mwhagedorn/AGC_DSKY_Replica/Photos/LED Layout.pdf

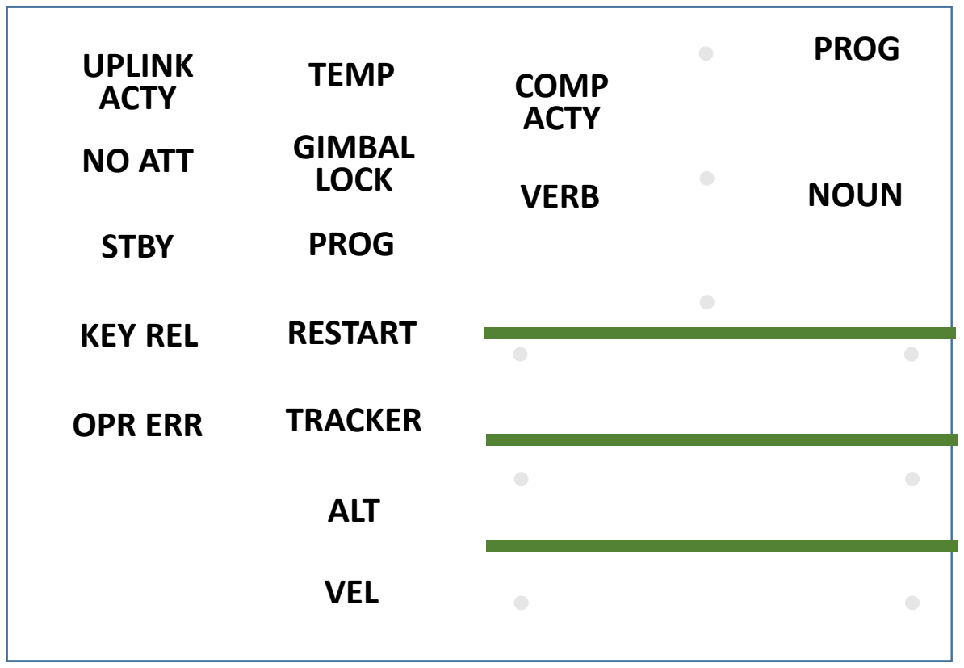
[picture p42: figure]
UPLINK ACTY; GIMBAL LOCK NO ATT; STBY; KEY REL; OPR ERR; TEMP; PROG; RESTART; TRACKER; ALT; VEL; COMP ACTY; VERB; NOUN
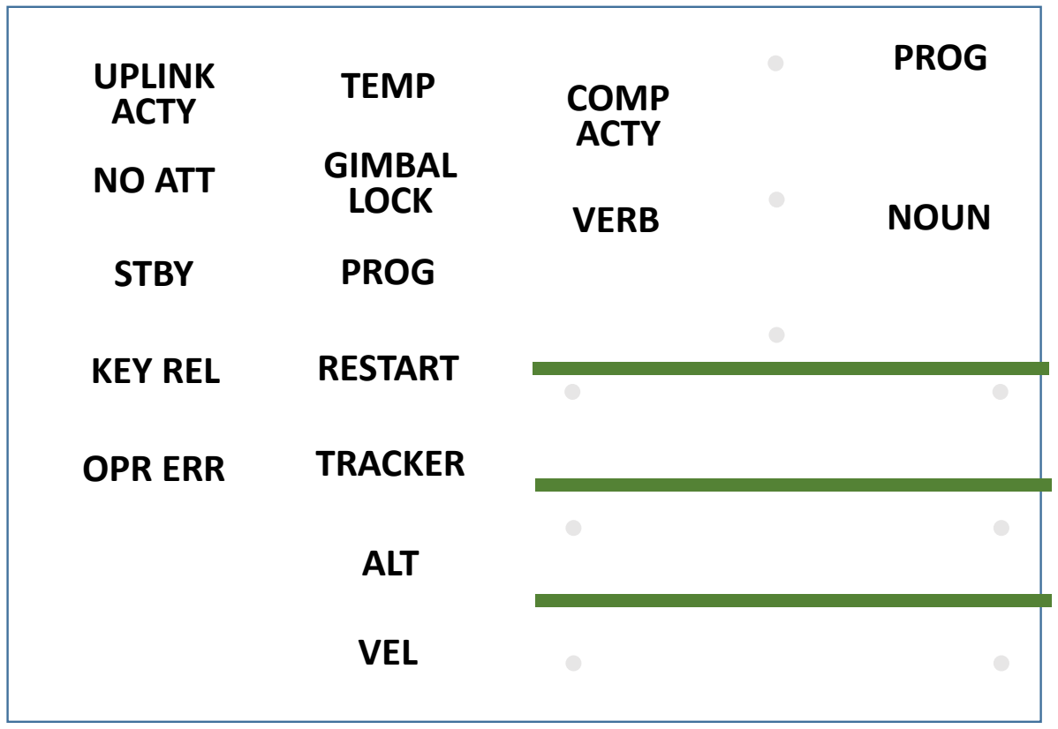
[picture p43: figure]
UPLINK ACTY; GIMBAL LOCK NO ATT; STBY; KEY REL; OPR ERR; TEMP; PROG; RESTART; TRACKER; ALT; VEL; COMP ACTY; VERB; NOUN
