mwhagedorn/AGC_DSKY_Replica/_ref/2226631608115538970.jpeg

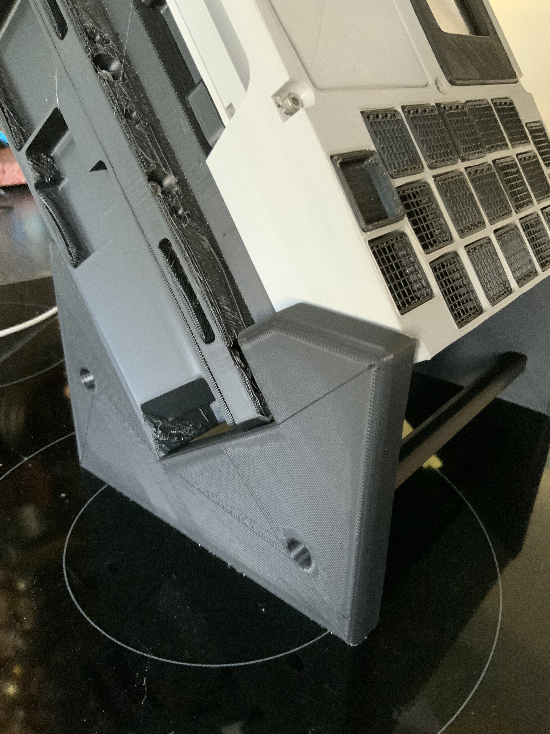
_ref/2226631608115538970.jpeg
