mwhagedorn/AGC_DSKY_Replica/_ref/2257991608116226826.jpeg

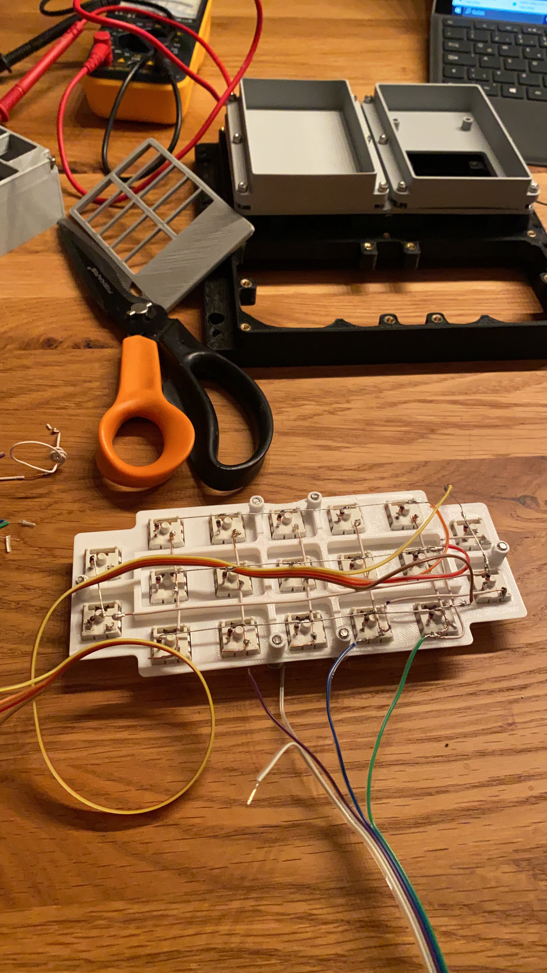
_ref/2257991608116226826.jpeg
