mwhagedorn/AGC_DSKY_Replica/_ref/original license.JPG

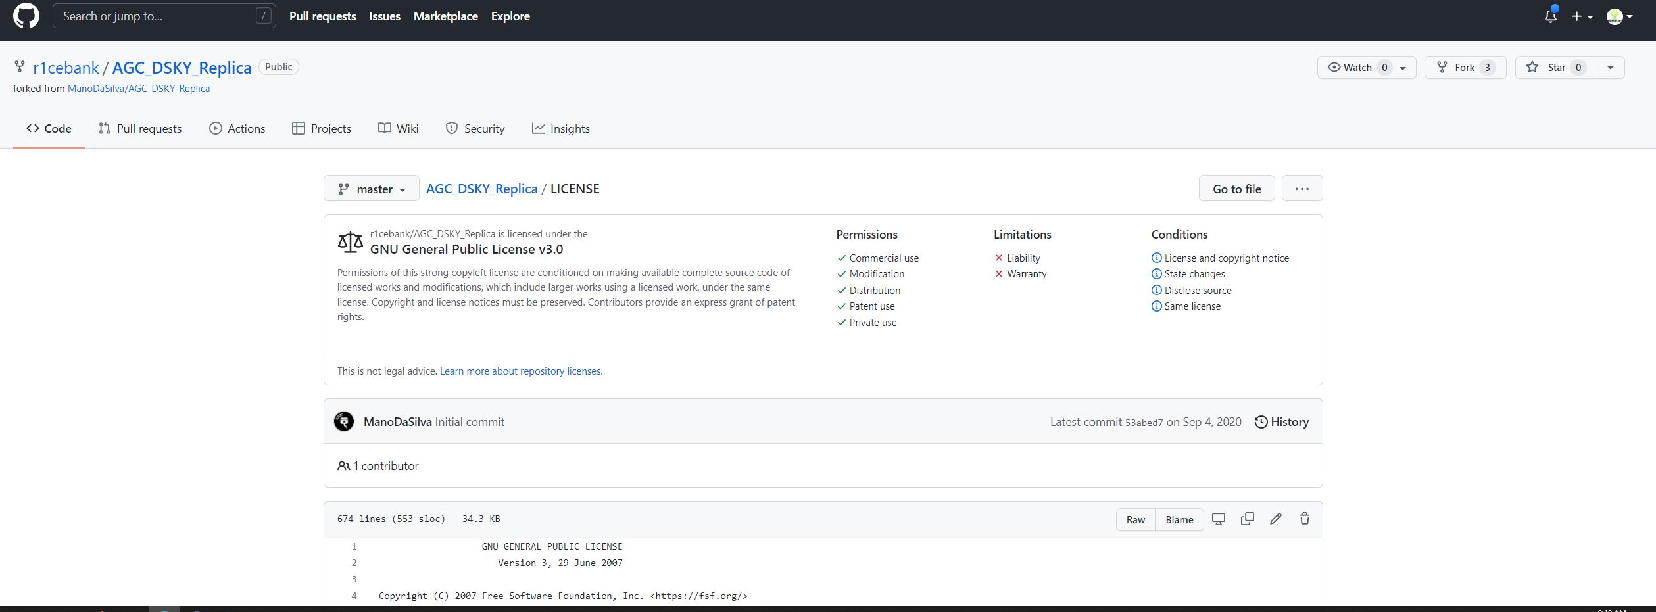
_ref/original license.JPG
