mwhagedorn/AGC_DSKY_Replica/Capture.JPG

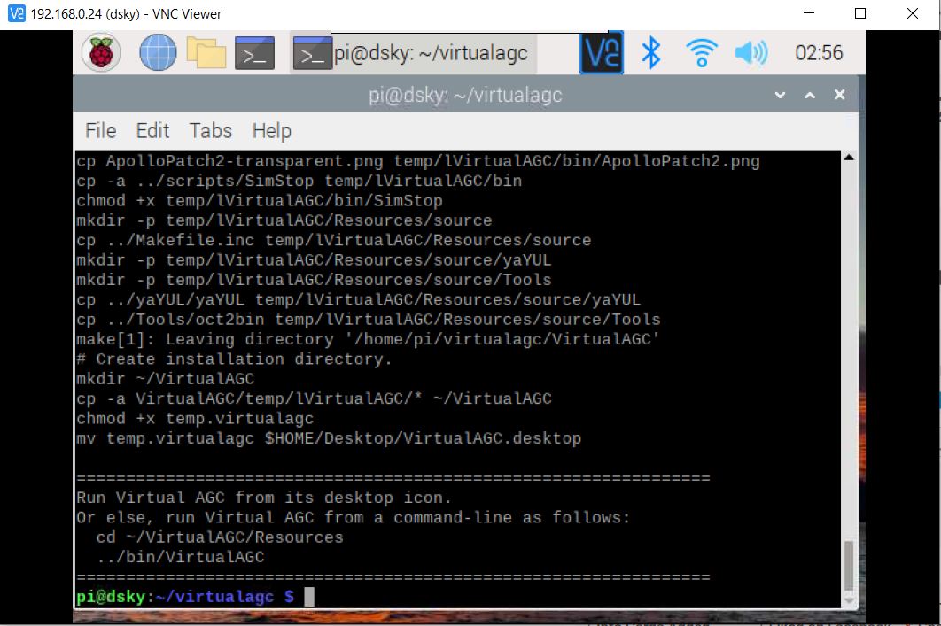
Capture.JPG
