mwhagedorn/AGC_DSKY_Replica/elixir_keyboard/dsky_keyboard_input/s-l400.jpg

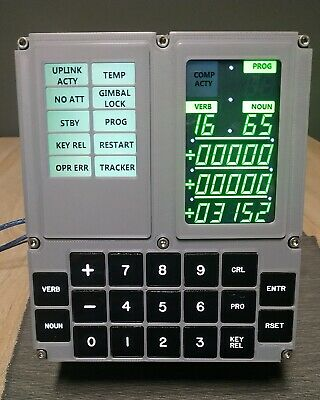
elixir_keyboard/dsky_keyboard_input/s-l400.jpg
