mwhagedorn/AGC_DSKY_Replica/Photos/2ADB911E-929F-4365-B093-D4F5ADEA4741.jpg

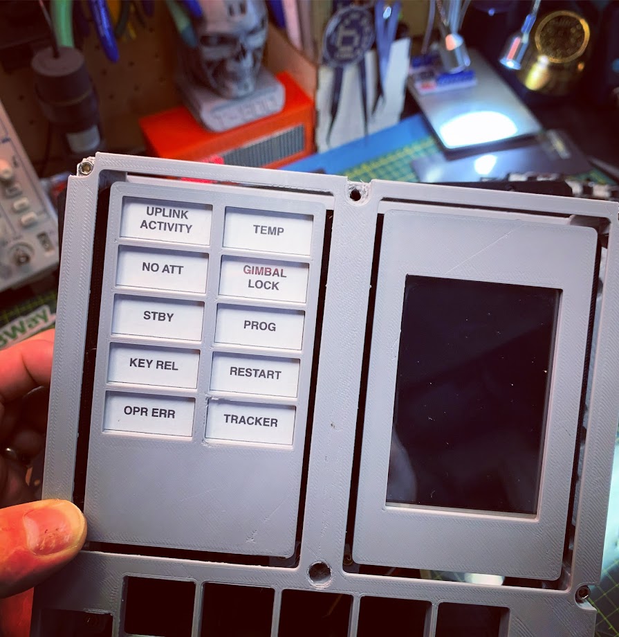
Photos/2ADB911E-929F-4365-B093-D4F5ADEA4741.jpg
