mwhagedorn/AGC_DSKY_Replica/Photos/7D12B138-8DF7-4C67-B199-76621CF2F9C1.jpg

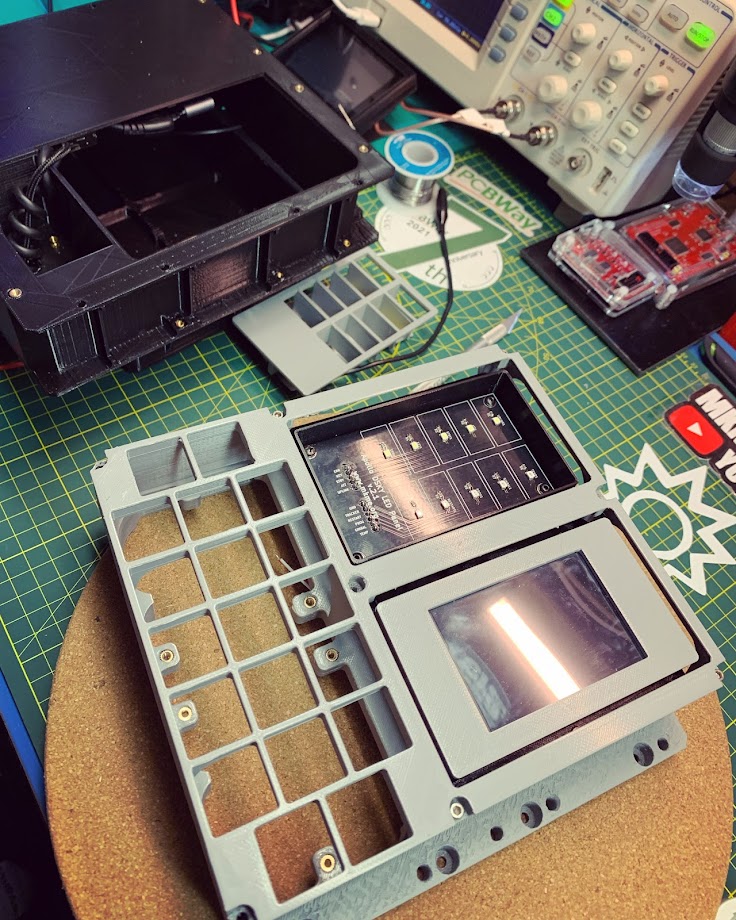
Photos/7D12B138-8DF7-4C67-B199-76621CF2F9C1.jpg
