mwhagedorn/AGC_DSKY_Replica/Photos/034ACF88-DA98-4DAB-A43B-C7C7AC291227.jpg

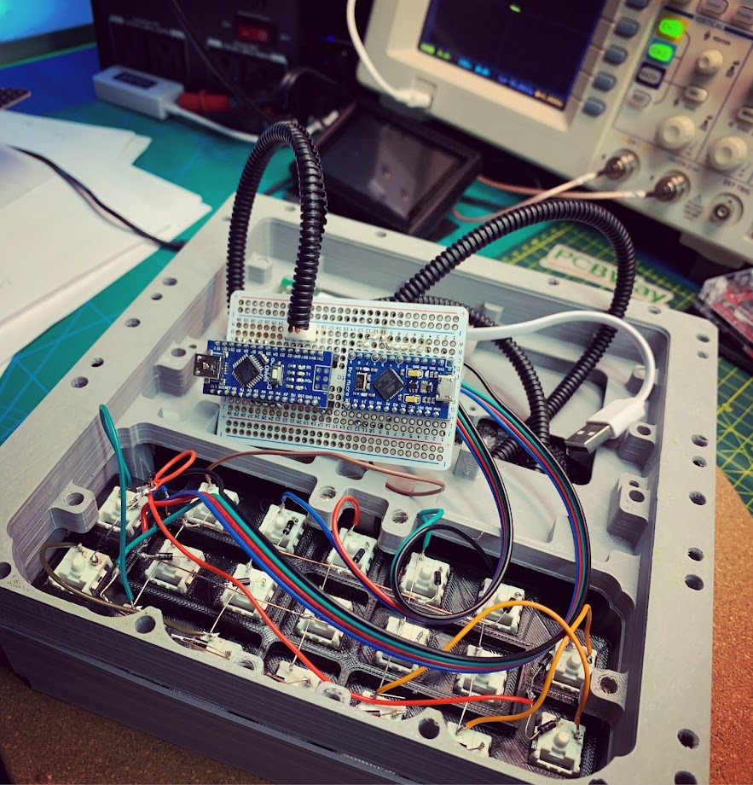
Photos/034ACF88-DA98-4DAB-A43B-C7C7AC291227.jpg
