mwhagedorn/AGC_DSKY_Replica/Photos/79AC465B-A962-4052-B77A-64AFA6F8622F.jpg

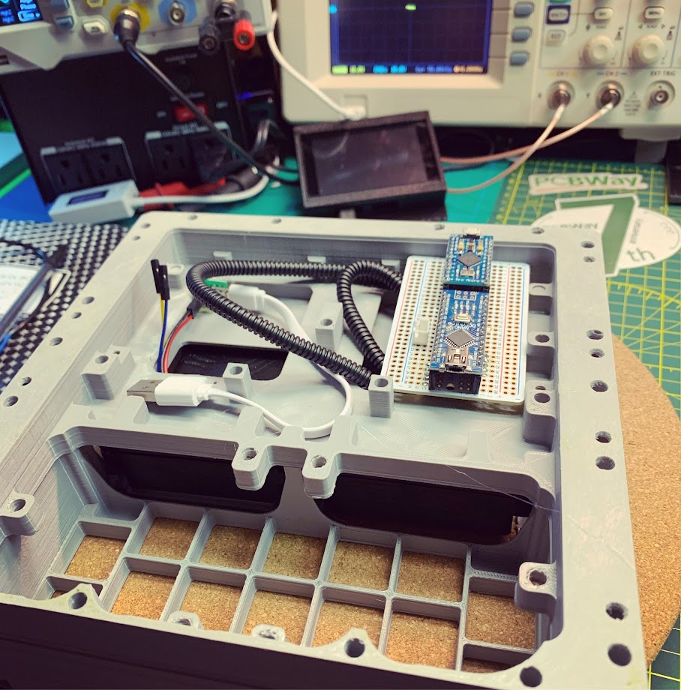
Photos/79AC465B-A962-4052-B77A-64AFA6F8622F.jpg
