mwhagedorn/AGC_DSKY_Replica/Photos/6656E1E4-DD0D-4B08-A72C-AD36040E90AD.jpg

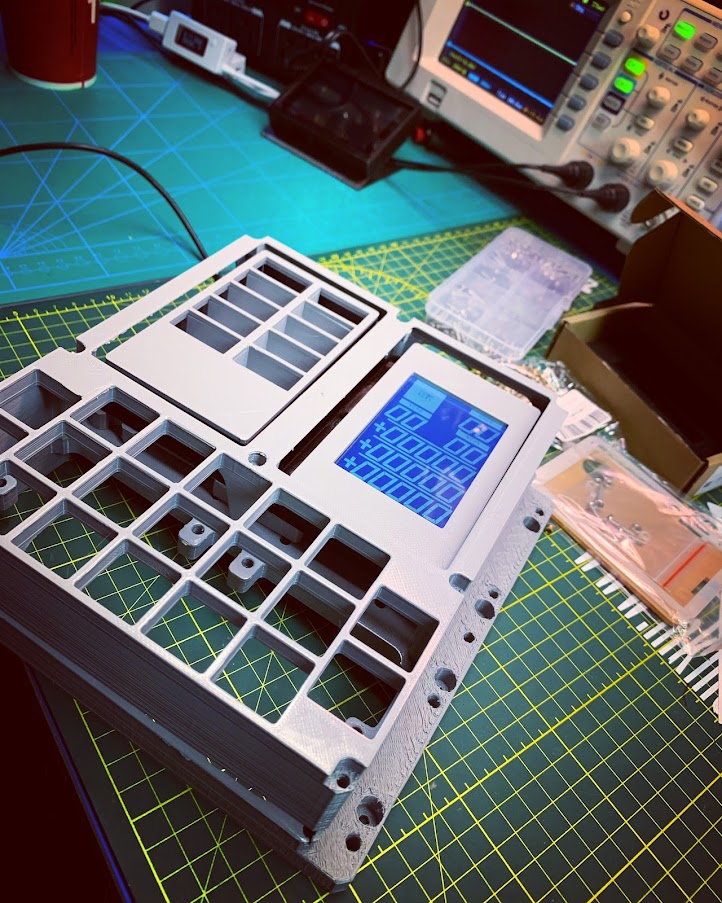
Photos/6656E1E4-DD0D-4B08-A72C-AD36040E90AD.jpg
