mwhagedorn/AGC_DSKY_Replica/Photos/7193211598702435594.jpg

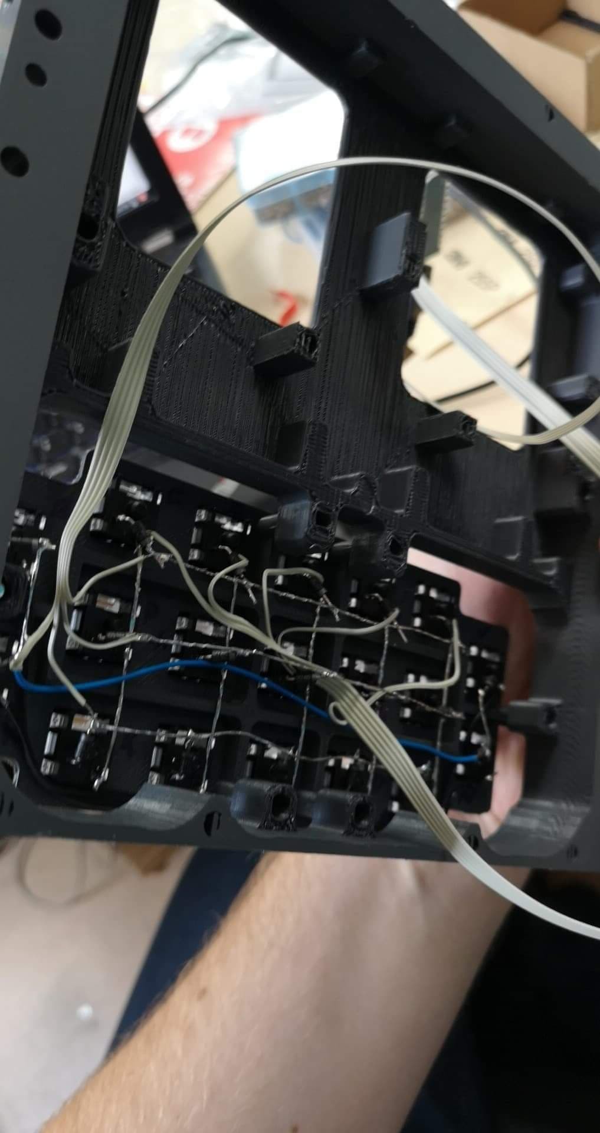
Photos/7193211598702435594.jpg
