mwhagedorn/AGC_DSKY_Replica/Photos/AGC Metal Tag.JPG

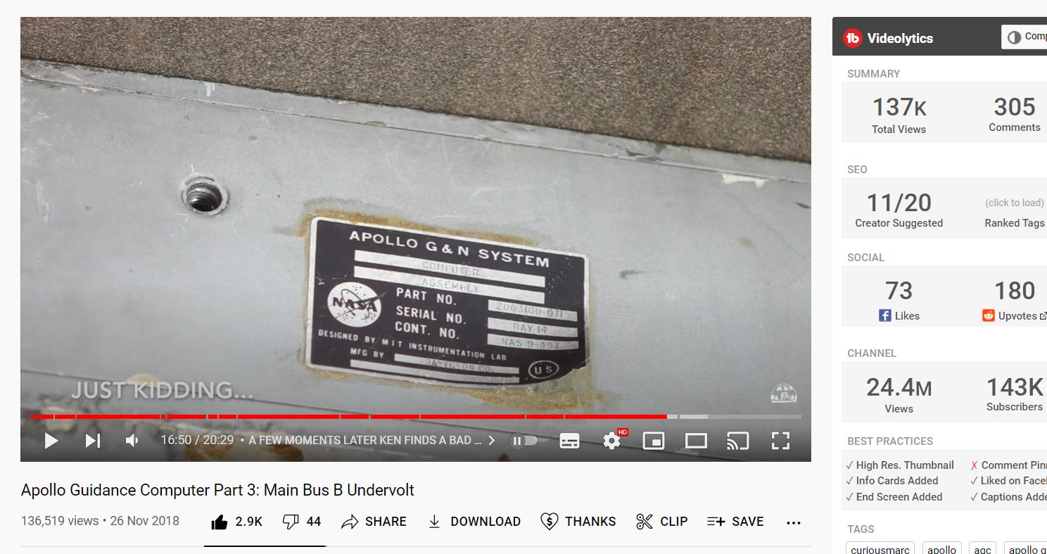
Photos/AGC Metal Tag.JPG
