mwhagedorn/AGC_DSKY_Replica/Photos/Alarms.jpg

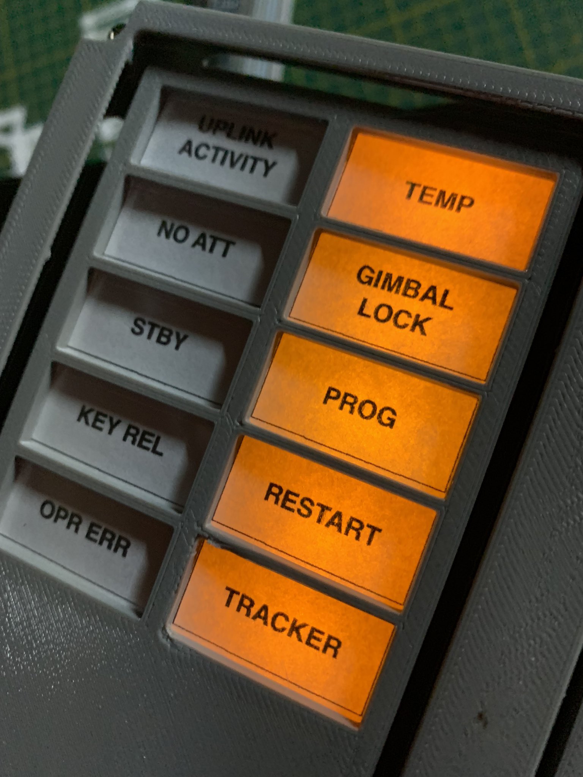
Photos/Alarms.jpg
