mwhagedorn/AGC_DSKY_Replica/Photos/Arduino NANO Pinout.png

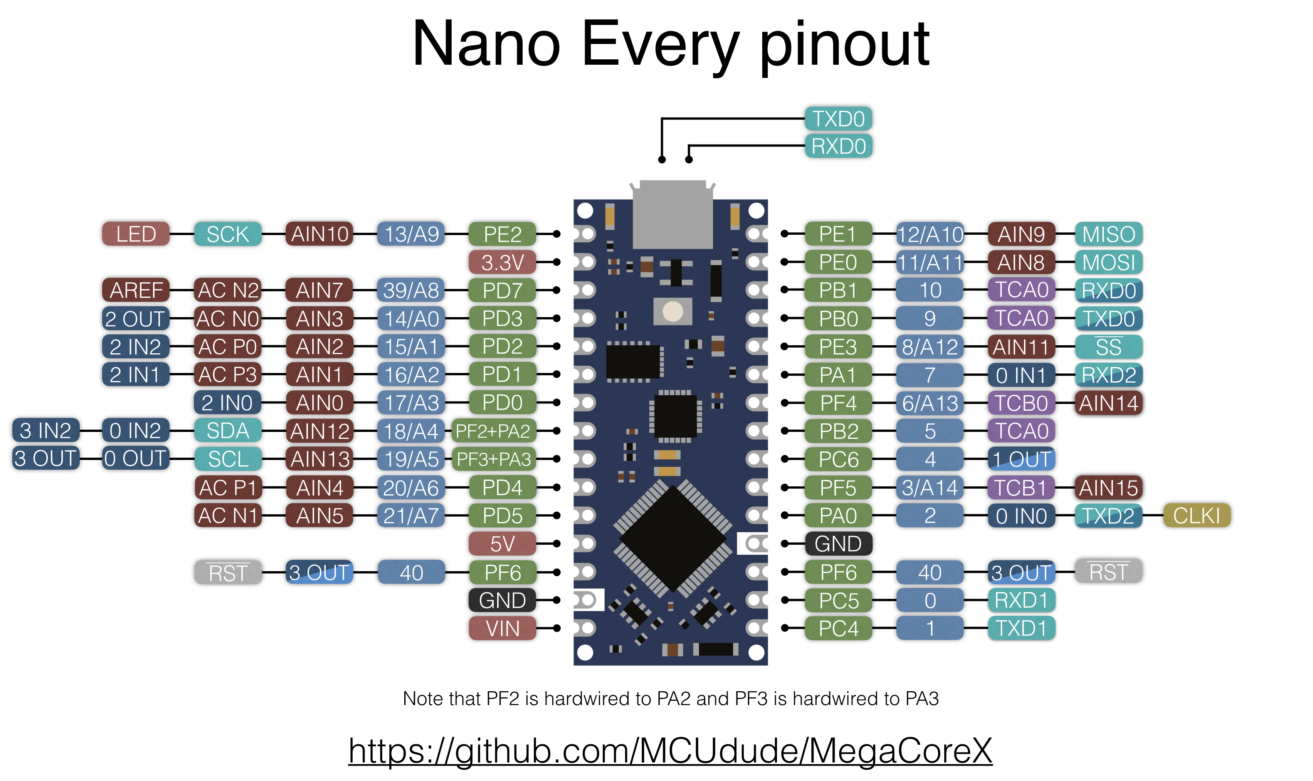
Photos/Arduino NANO Pinout.png
