mwhagedorn/AGC_DSKY_Replica/Photos/B37C9473-D6C6-45E8-A71C-F1733F7B08E9.jpg

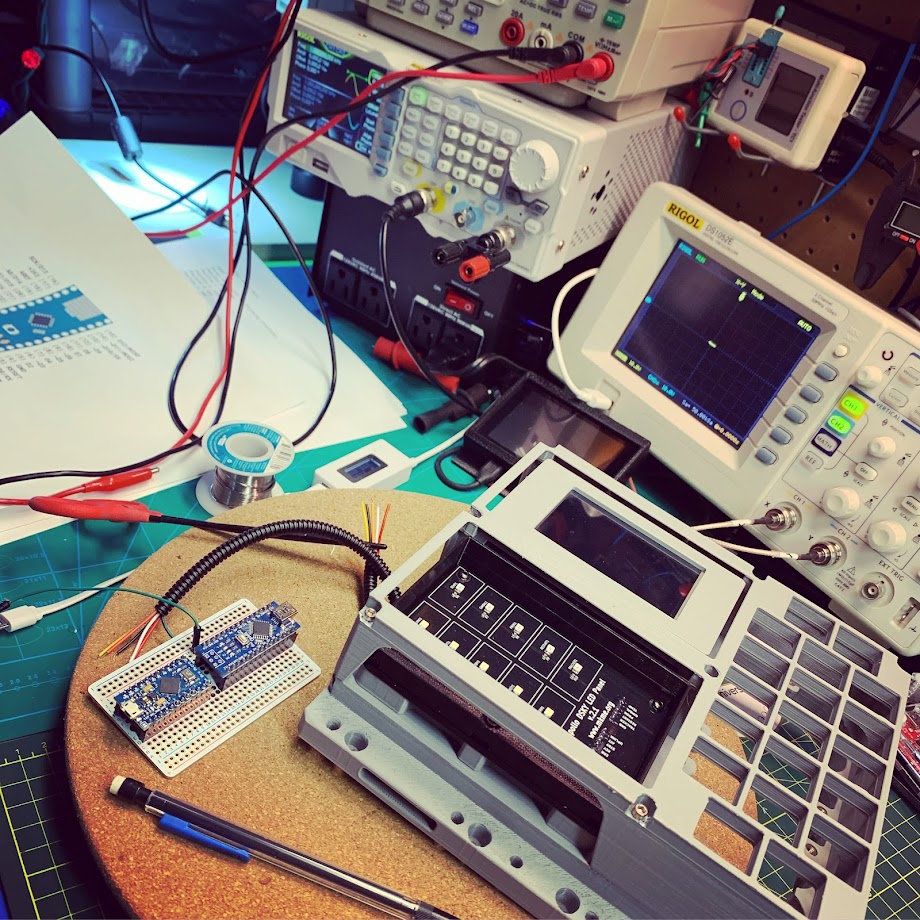
Photos/B37C9473-D6C6-45E8-A71C-F1733F7B08E9.jpg
