mwhagedorn/AGC_DSKY_Replica/Photos/Capture2.PNG

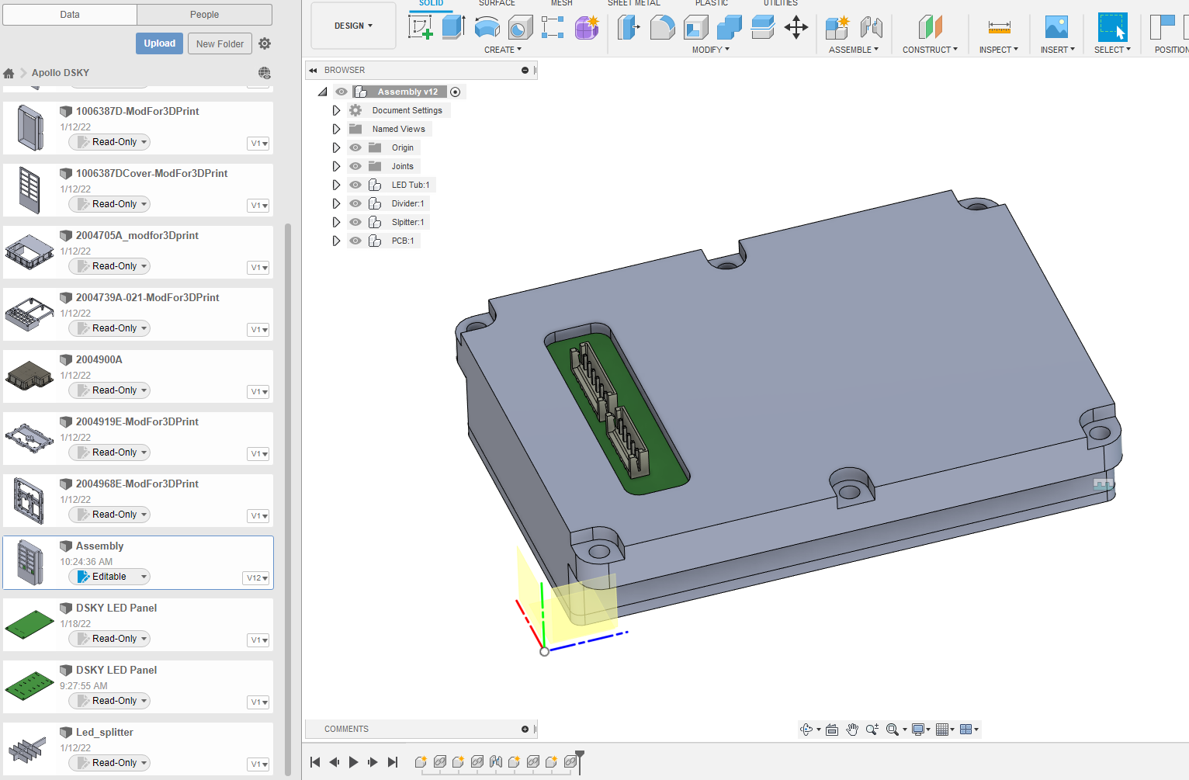
Photos/Capture2.PNG
