mwhagedorn/AGC_DSKY_Replica/Photos/Capture.PNG

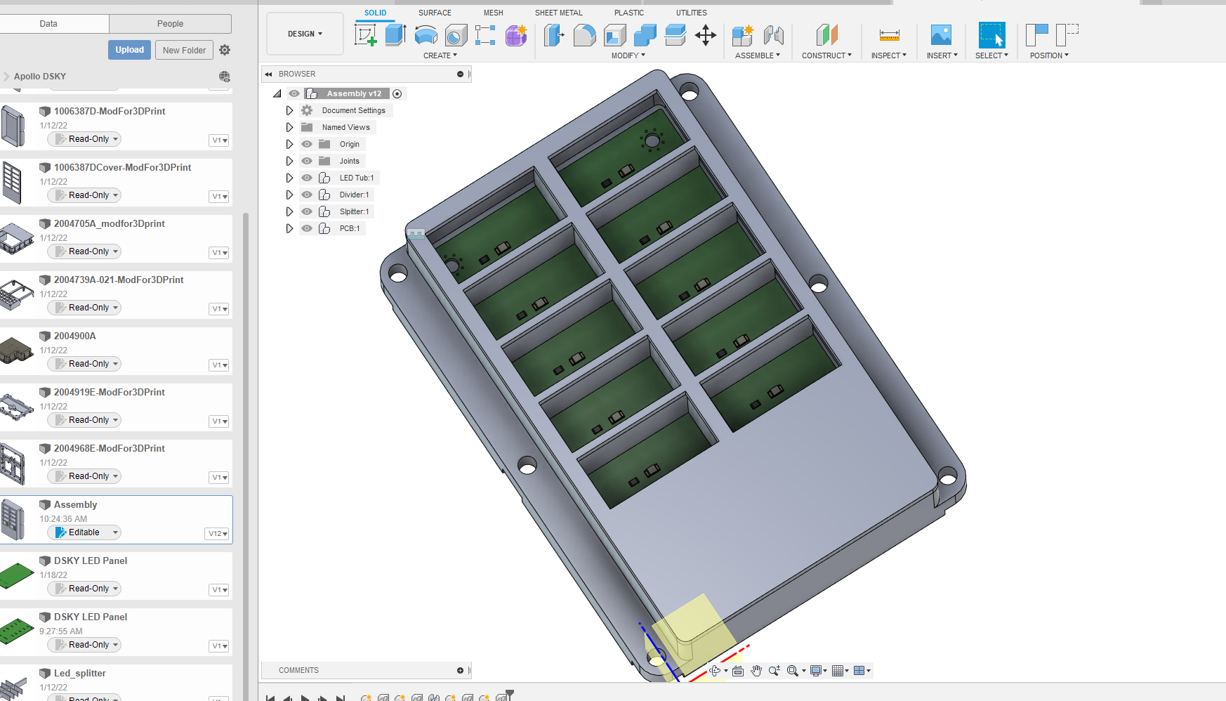
Photos/Capture.PNG
