mwhagedorn/AGC_DSKY_Replica/Photos/DSKY Tub PrusaSlicer.JPG

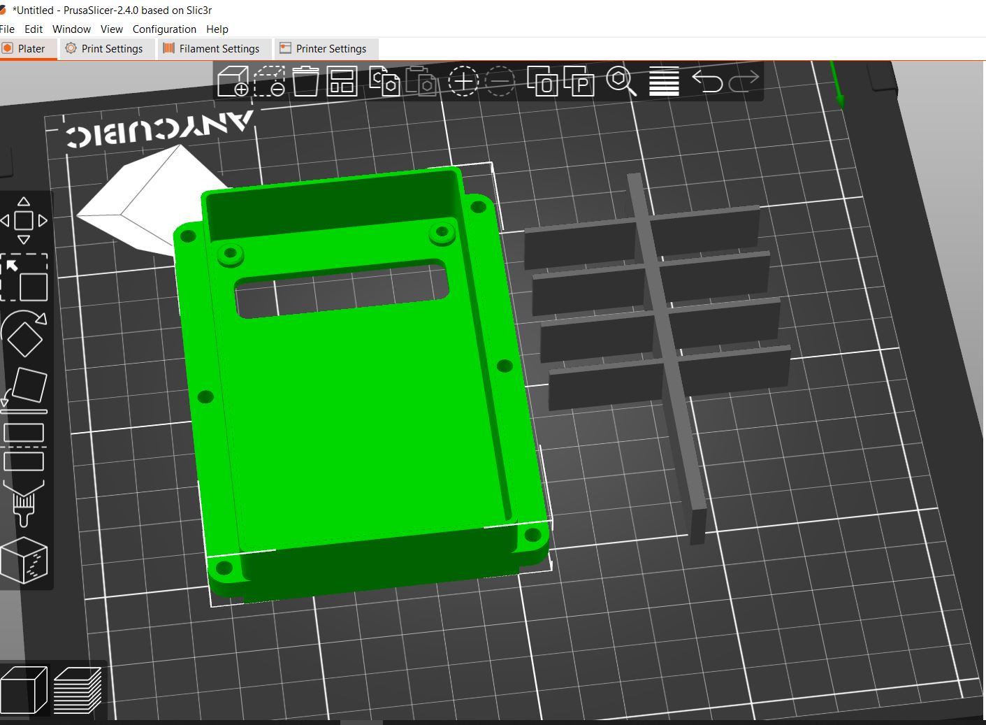
Photos/DSKY Tub PrusaSlicer.JPG
