mwhagedorn/AGC_DSKY_Replica/Photos/IMG_3737.jpg

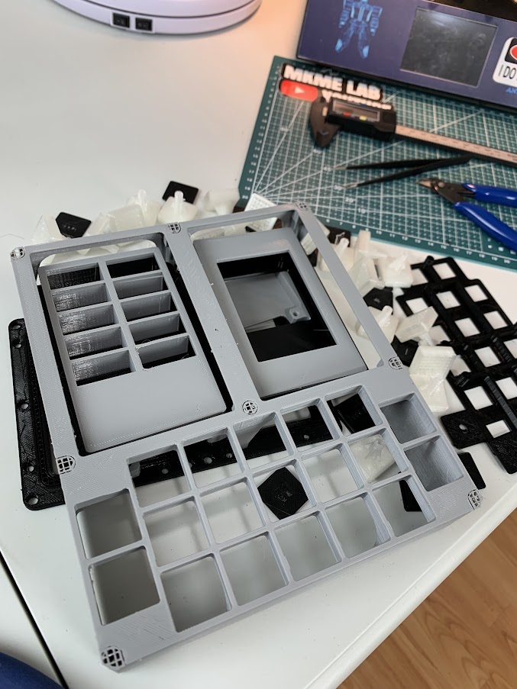
Photos/IMG_3737.jpg
