mwhagedorn/AGC_DSKY_Replica/Photos/IMG_3739.jpg

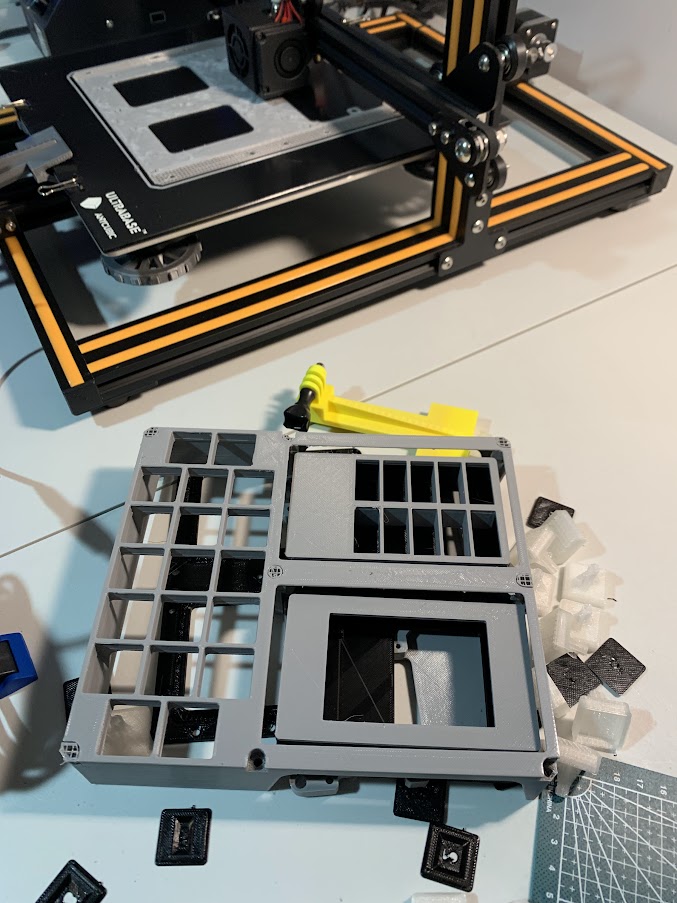
Photos/IMG_3739.jpg
