mwhagedorn/AGC_DSKY_Replica/Photos/IMG_3753.jpg

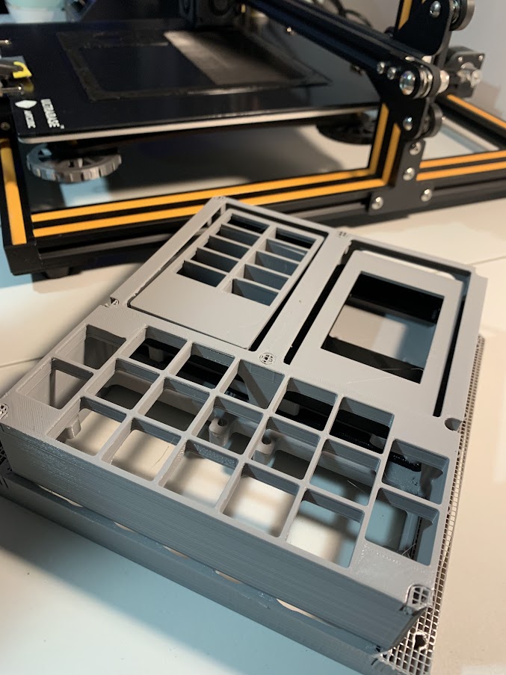
Photos/IMG_3753.jpg
