mwhagedorn/AGC_DSKY_Replica/Photos/IMG_4166.jpg

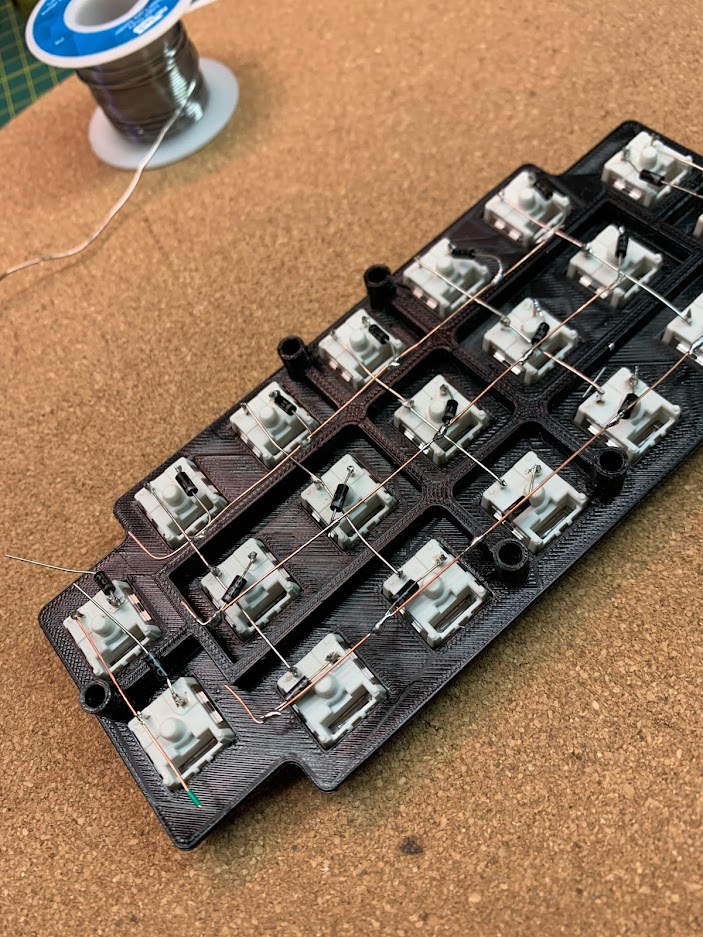
Photos/IMG_4166.jpg
