mwhagedorn/AGC_DSKY_Replica/Photos/IMG_4192.jpg

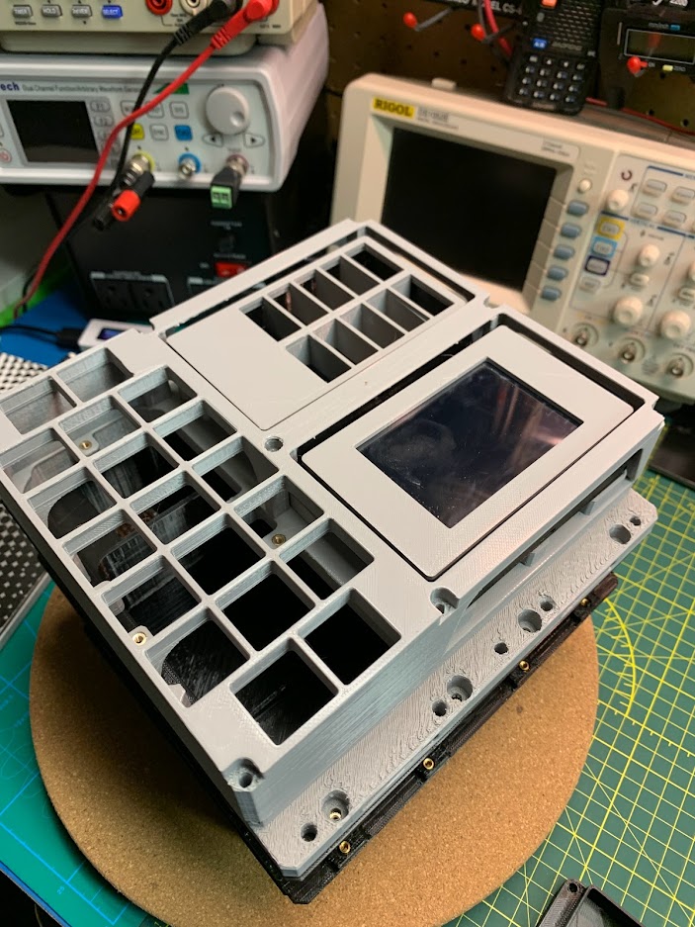
Photos/IMG_4192.jpg
