mwhagedorn/AGC_DSKY_Replica/Photos/IMG_4227.jpg

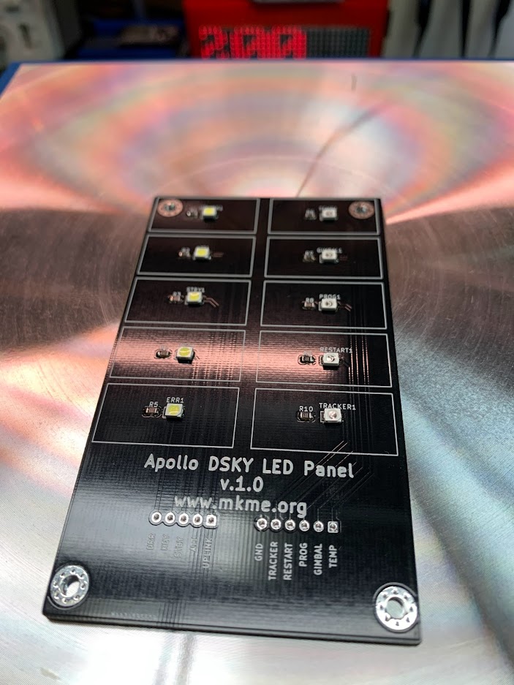
Photos/IMG_4227.jpg
