mwhagedorn/AGC_DSKY_Replica/Photos/IMG_4419.jpg

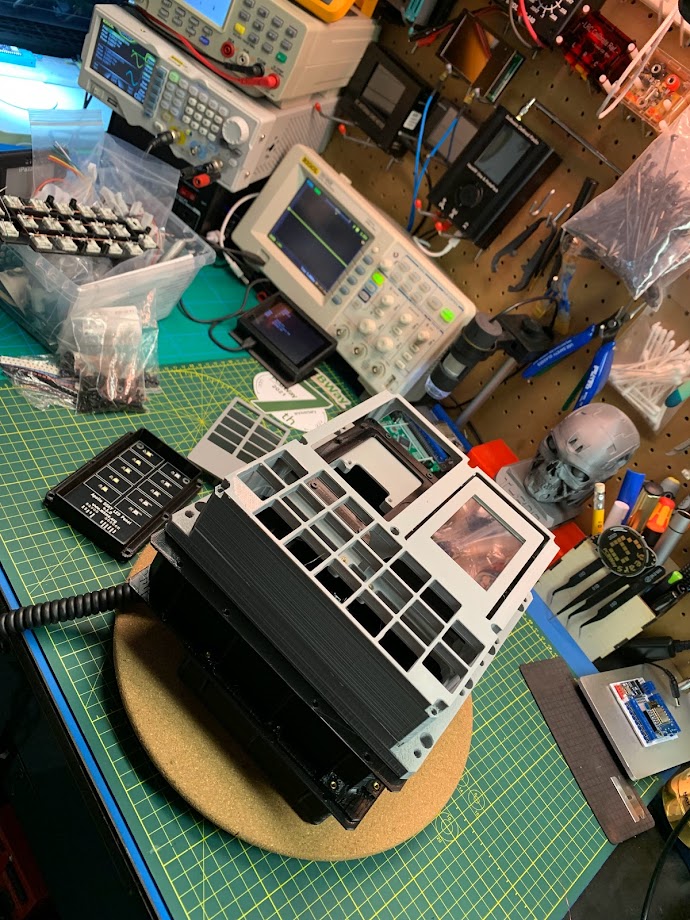
Photos/IMG_4419.jpg
