mwhagedorn/AGC_DSKY_Replica/Photos/IMG_4575.jpg

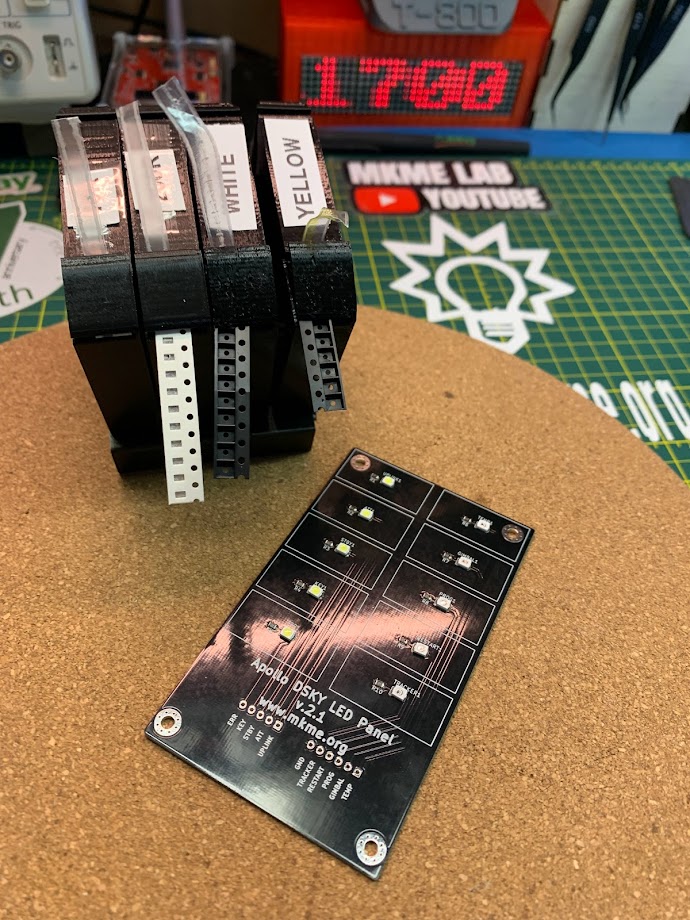
Photos/IMG_4575.jpg
