mwhagedorn/AGC_DSKY_Replica/Photos/IMG_4593.jpg

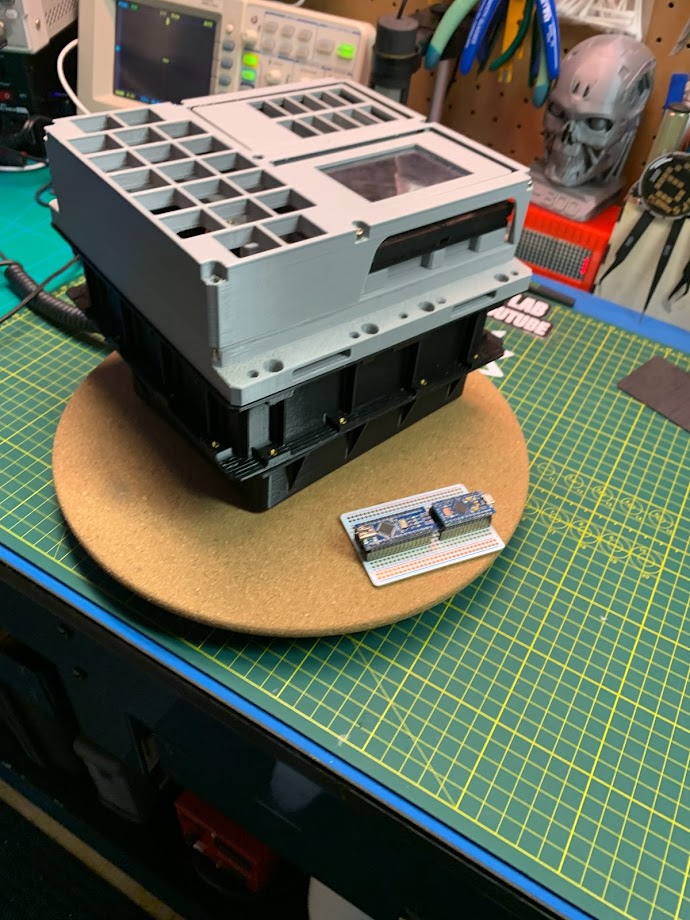
Photos/IMG_4593.jpg
