mwhagedorn/AGC_DSKY_Replica/Photos/IMG_4597.jpg

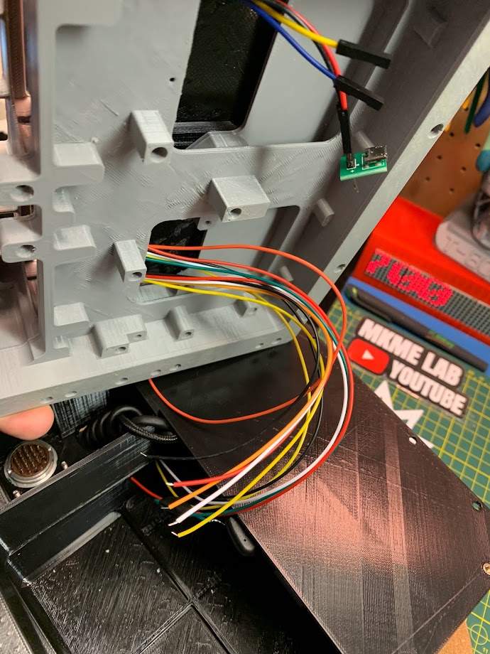
Photos/IMG_4597.jpg
