mwhagedorn/AGC_DSKY_Replica/Photos/IMG_4638.jpg

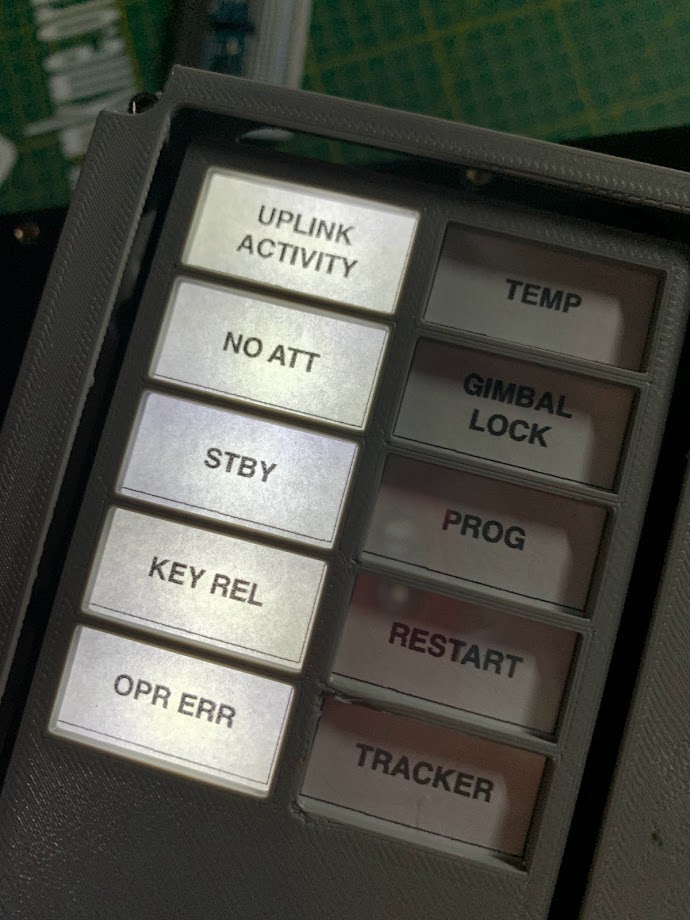
Photos/IMG_4638.jpg
