mwhagedorn/AGC_DSKY_Replica/Photos/IMG_4691.jpg

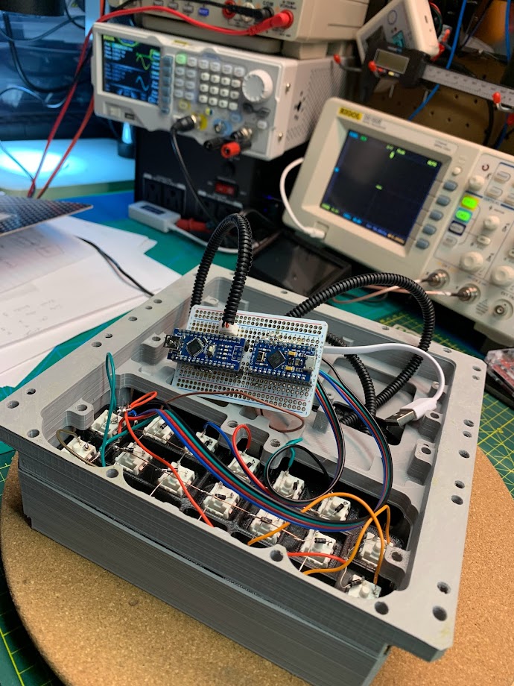
Photos/IMG_4691.jpg
