mwhagedorn/AGC_DSKY_Replica/Photos/IMG_4692.jpg

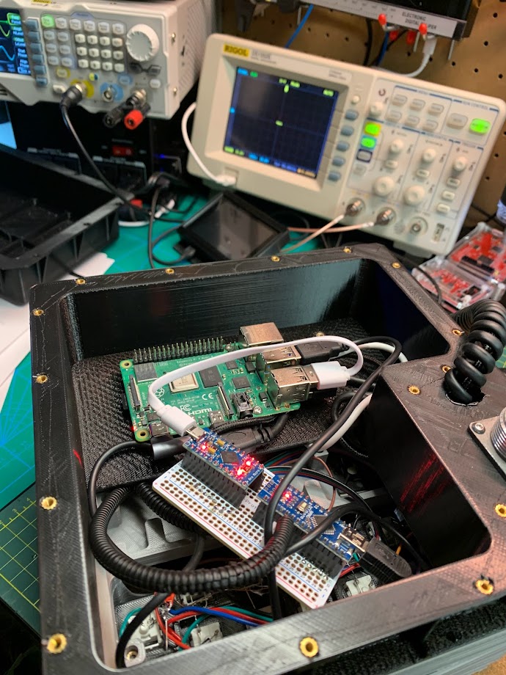
Photos/IMG_4692.jpg
