mwhagedorn/AGC_DSKY_Replica/Photos/IMG_4697.jpg

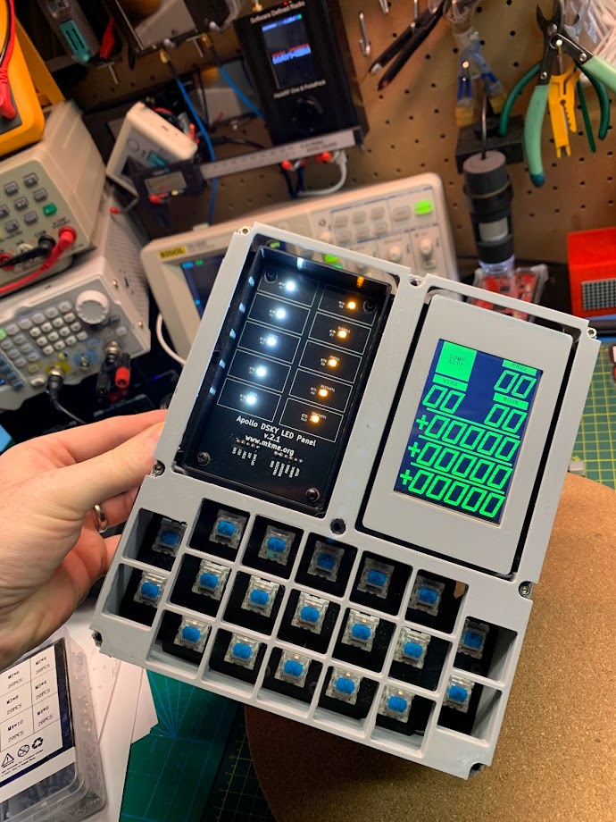
Photos/IMG_4697.jpg
