mwhagedorn/AGC_DSKY_Replica/Photos/IMG_4704.jpg

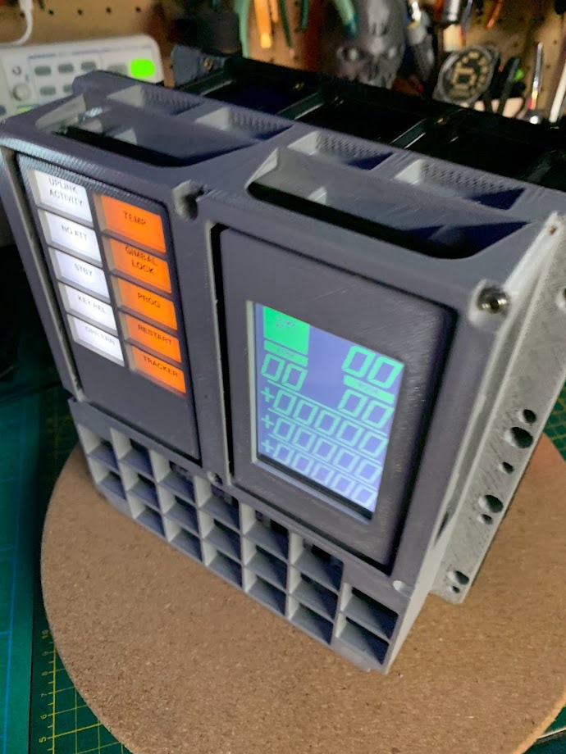
Photos/IMG_4704.jpg
