mwhagedorn/AGC_DSKY_Replica/Photos/IMG_4706.jpg

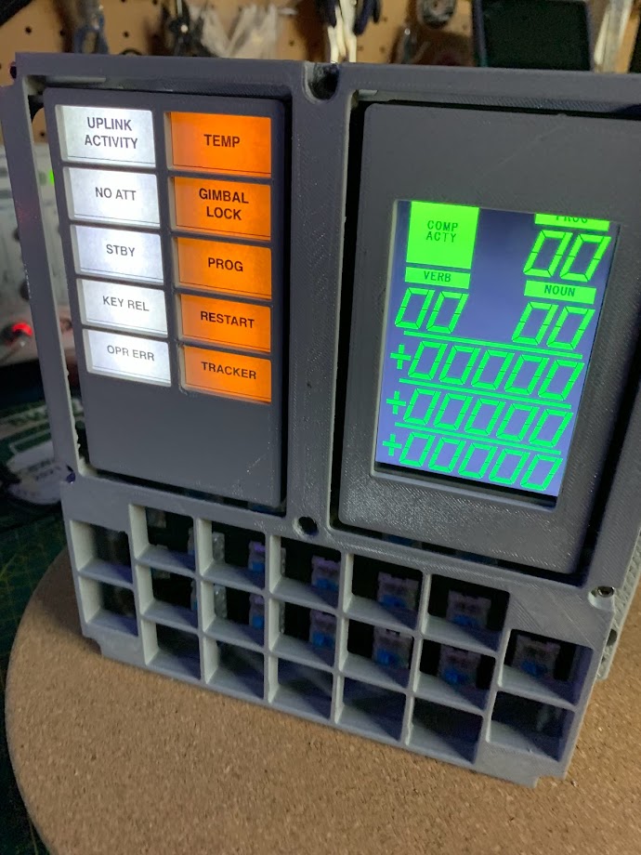
Photos/IMG_4706.jpg
