mwhagedorn/AGC_DSKY_Replica/Photos/IMG_4711.jpg

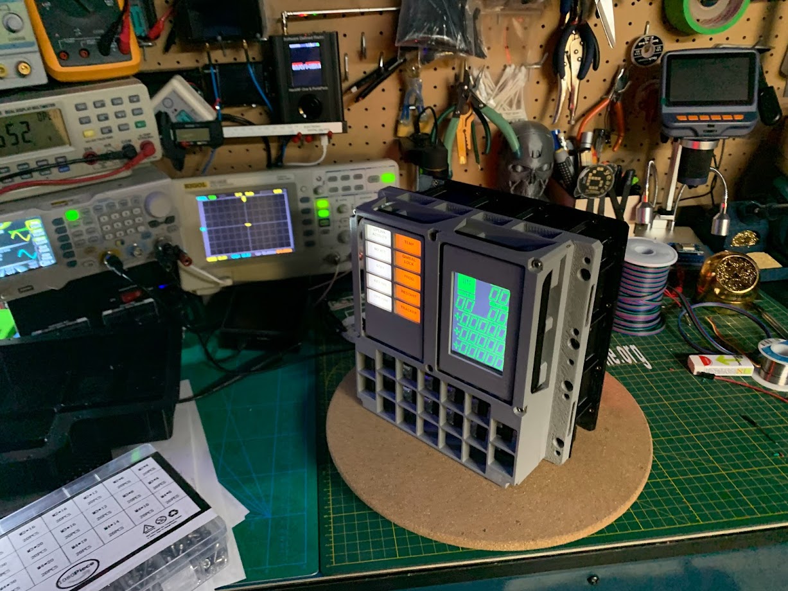
Photos/IMG_4711.jpg
