mwhagedorn/AGC_DSKY_Replica/Photos/IMG_4735.jpg

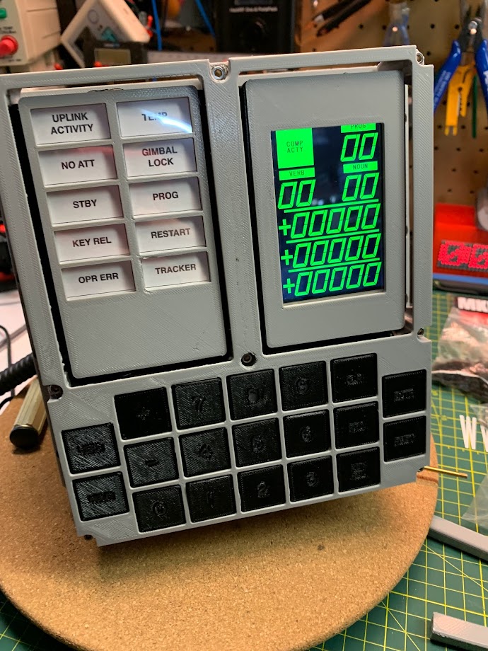
Photos/IMG_4735.jpg
