mwhagedorn/AGC_DSKY_Replica/Photos/IMG_4737.jpg

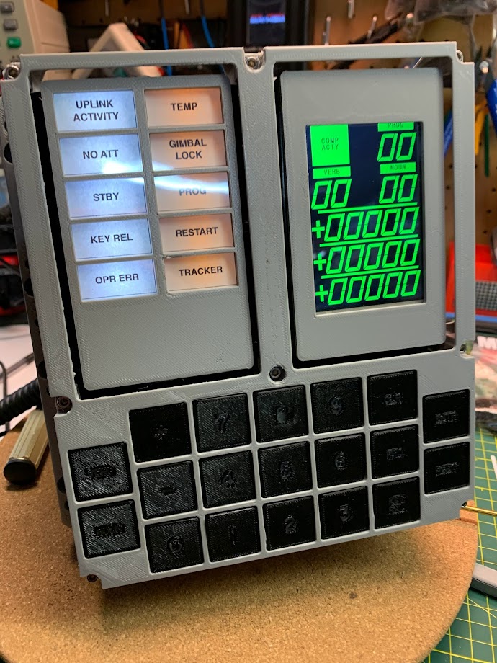
Photos/IMG_4737.jpg
