mwhagedorn/AGC_DSKY_Replica/Photos/IMG_4747.jpg

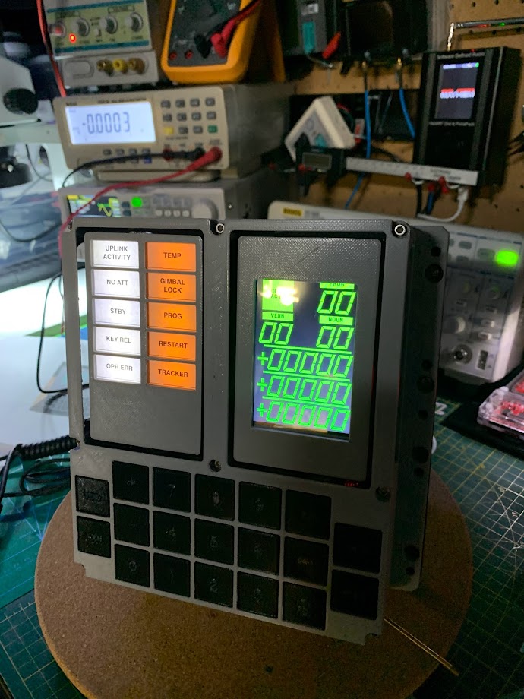
Photos/IMG_4747.jpg
