mwhagedorn/AGC_DSKY_Replica/Photos/IMG_4763.jpg

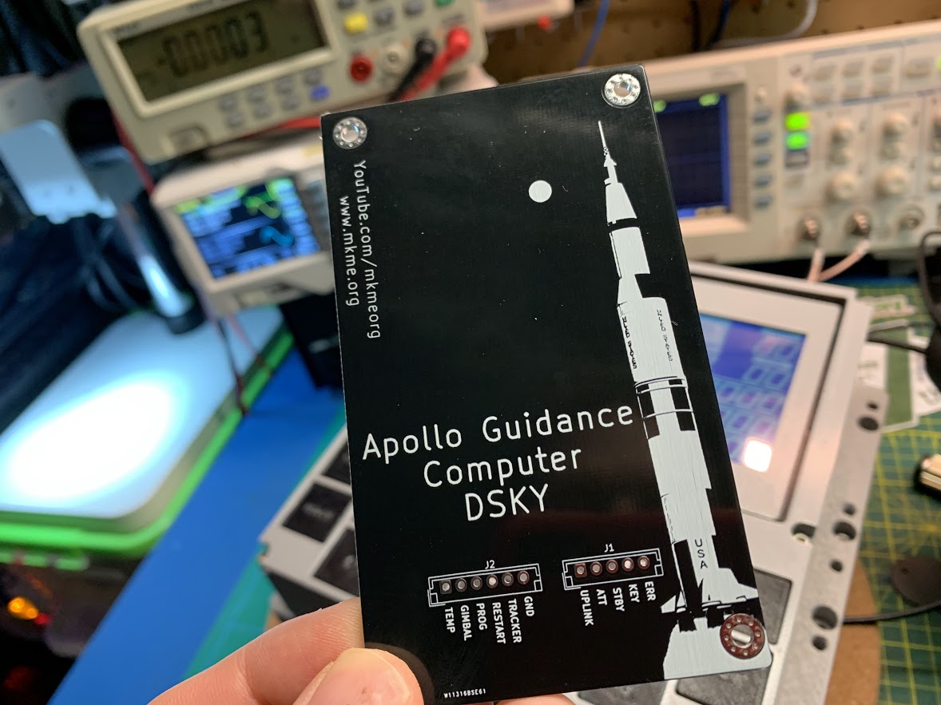
Photos/IMG_4763.jpg
