mwhagedorn/AGC_DSKY_Replica/Photos/MKME Lab LED Panel/IMG_4998.jpg

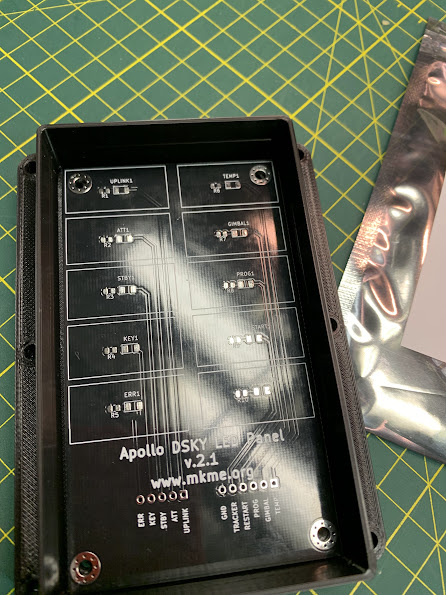
Photos/MKME Lab LED Panel/IMG_4998.jpg
