mwhagedorn/AGC_DSKY_Replica/Photos/MKME Lab LED Panel/IMG_4999.jpg

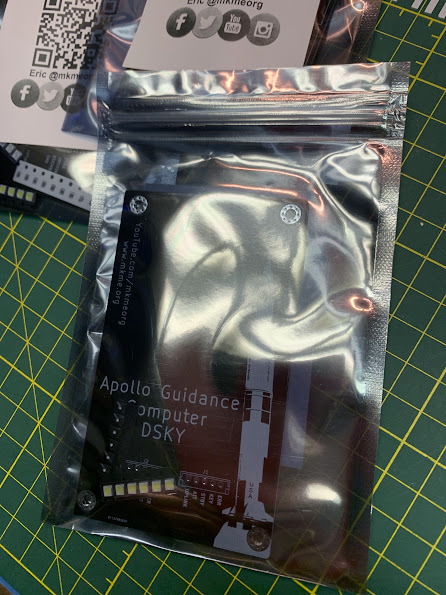
Photos/MKME Lab LED Panel/IMG_4999.jpg
