mwhagedorn/AGC_DSKY_Replica/Photos/MKME Lab LED Panel/IMG_5002.jpg

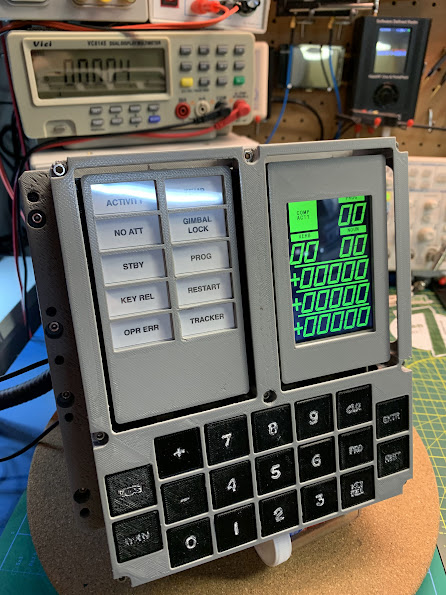
Photos/MKME Lab LED Panel/IMG_5002.jpg
