mwhagedorn/AGC_DSKY_Replica/Photos/Nextion Editor Compiling.PNG

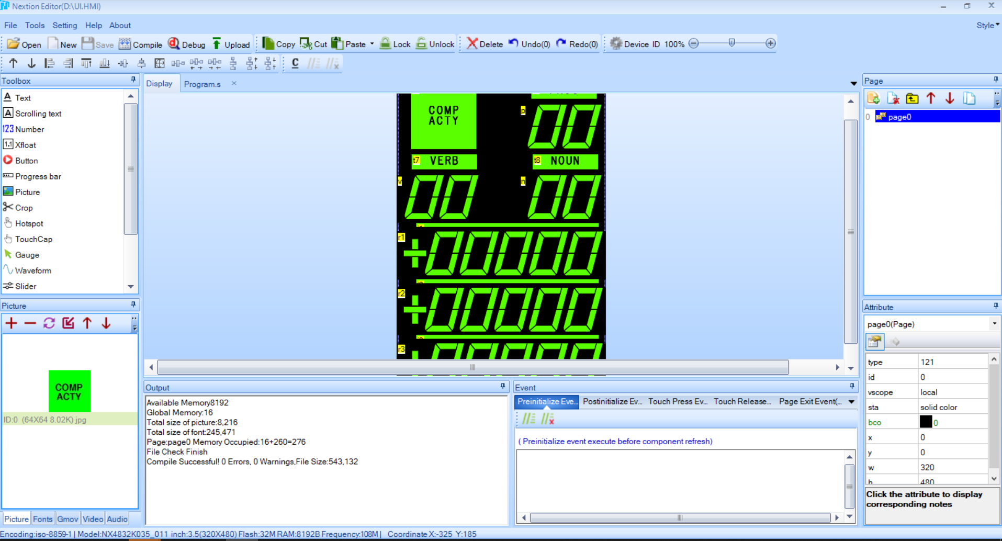
Photos/Nextion Editor Compiling.PNG
