mwhagedorn/AGC_DSKY_Replica/_ref/OpenDsky/FE0BBXNJCUUHB4U.stl

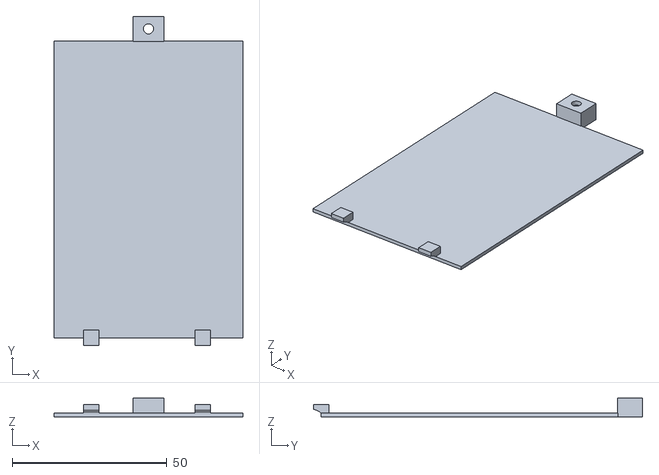
[picture p90: CAD file, 2021-12-15]
_ref/OpenDsky/FE0BBXNJCUUHB4U.stl
61.0 x 106.3 x 6.00
