mwhagedorn/AGC_DSKY_Replica/_ref/OpenDsky/FY0YLKKJCUUHB52.stl

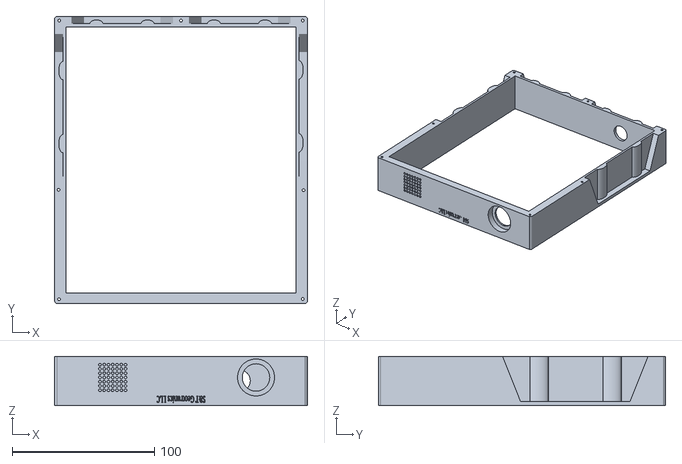
[picture p91: CAD file, 2021-12-15]
_ref/OpenDsky/FY0YLKKJCUUHB52.stl
178.0 x 202.0 x 34.5
