mwhagedorn/AGC_DSKY_Replica/_ref/OpenDsky/FBJPRH3JCAUBG8E.stl

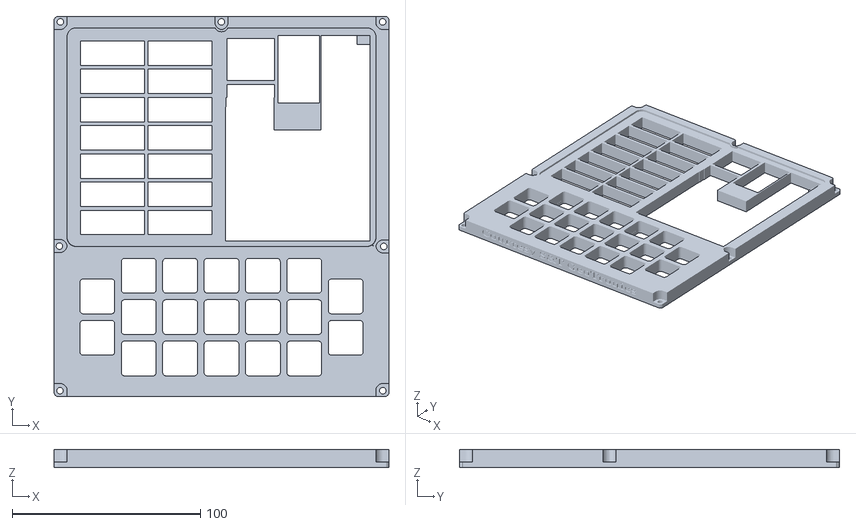
[picture p92: CAD file, 2021-12-15]
_ref/OpenDsky/FBJPRH3JCAUBG8E.stl
178.0 x 202.0 x 9.80
