mwhagedorn/AGC_DSKY_Replica/_ref/OpenDsky/FNCK92GJCUURA9X.stl

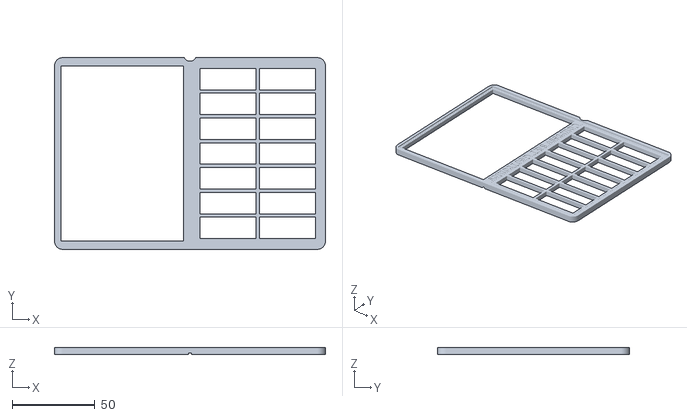
[picture p93: CAD file, 2021-12-15]
_ref/OpenDsky/FNCK92GJCUURA9X.stl
164.0 x 116.0 x 4.50
