mwhagedorn/AGC_DSKY_Replica/_ref/OpenDsky/FXR26UVJCUUHB4Y.stl

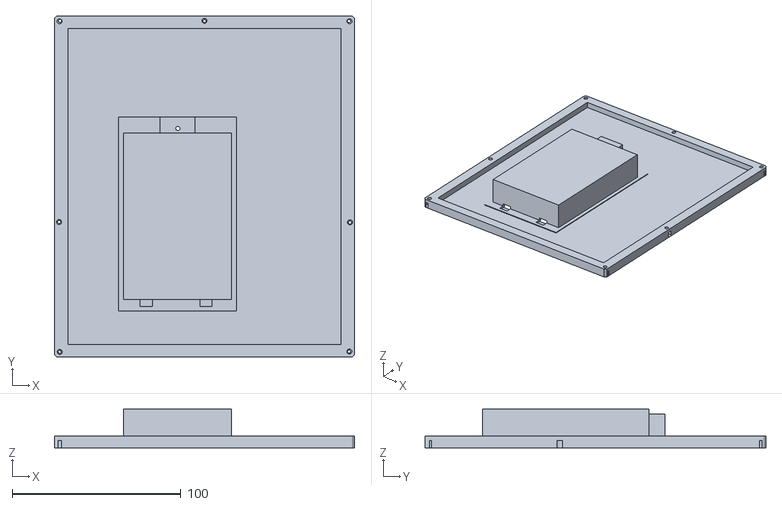
[picture p94: CAD file, 2021-12-15]
_ref/OpenDsky/FXR26UVJCUUHB4Y.stl
178.0 x 202.0 x 23.1
