mwhagedorn/AGC_DSKY_Replica/(commit log)

2021-12-15 Apollo DSKY Stl updates
    [FBJPRH3JCAUBG8E.stl, FE0BBXNJCUUHB4U.stl, FNCK92GJCUURA9X.stl, FXR26UVJCUUHB4Y.stl, FY0YLKKJCUUHB52.stl]
2021-12-22 Printing Photos
2022-01-23 Create Faster serial speed- Nextion+Arduino Tutorial #1 Beginner's Guide - YouTube.url
2022-04-02 Fixed ASCII char problem
    [dsky_keyboard_arduinoMKMELab.ino]
2022-04-21 LED Panel Added to Store.MKME.org
2023-09-07 refactored arduino display scripts
2026-08-08 fix: move nextion serial to pins 4,5
    [dsky_display.ino, dsky_keyboard_arduinoMKMELab.ino]
